lucatib/amplikt88/docs/datasheets/README.md

# Datasheets

| File | Part | Source |
|---|---|---|
| `kt88-jj.pdf` | JJ Electronic KT88: ratings, curves (ultralinear 40 % taps), pinout, glass max 52 mm, height max 125 mm | <https://www.drtube.com/datasheets/kt88-jj2003.pdf> |
| `kt88-genalex-gold-lion.pdf` | Genalex Gold Lion KT88 | <https://img.audiomania.ru/data/genalex_kt88_gold_lion_matched.pdf> |
| `ecc83-philips.pdf` | Philips ECC83, 22.2 mm max diameter | <https://frank.pocnet.net/sheets/010/e/ECC83.pdf> |
| `belton-vt8-octal-socket.pdf` | Belton VT8 octal socket (PCB mount), dimensions and PCB holes | <https://partsconnexion.com/product_images/downloads/BELTON-54795.pdf> |
