lucatib/amplikt88/3dmodels/Noval_PCB_socket.step

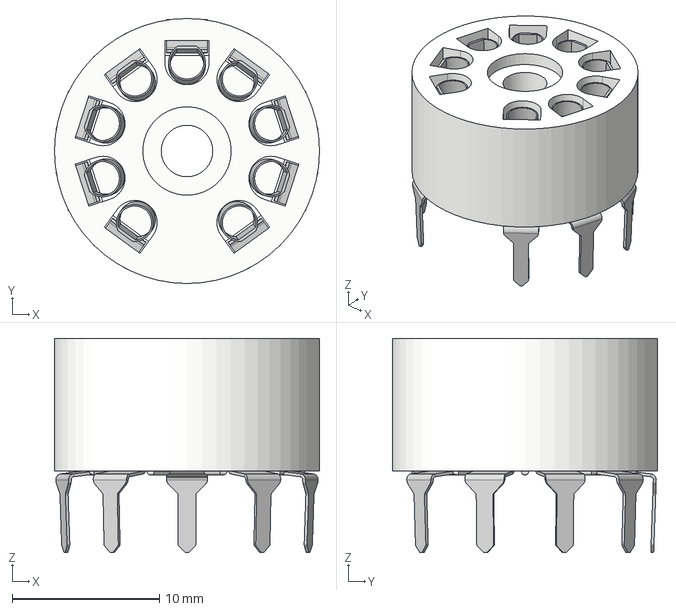
[picture p6: CAD file, 2026-11-11]
3dmodels/Noval_PCB_socket.step
18.0 x 18.0 x 14.6 mm
