lucatib/amplikt88/3dmodels/KT88.step

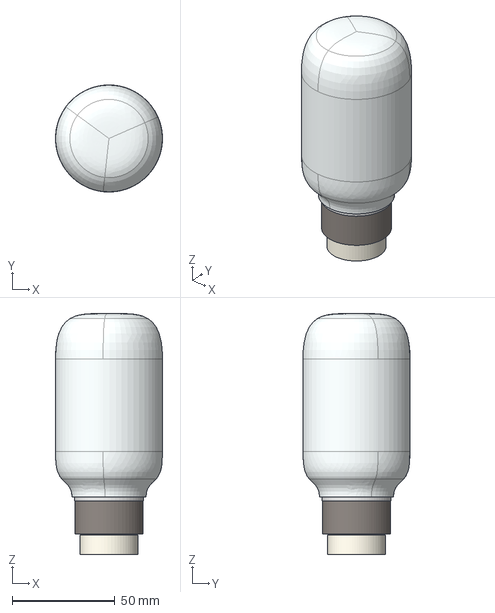
[picture p7: CAD file, 2026-11-11]
3dmodels/KT88.step
52.0 x 52.0 x 117.0 mm
