lucatib/amplikt88/3dmodels/ECC83.step

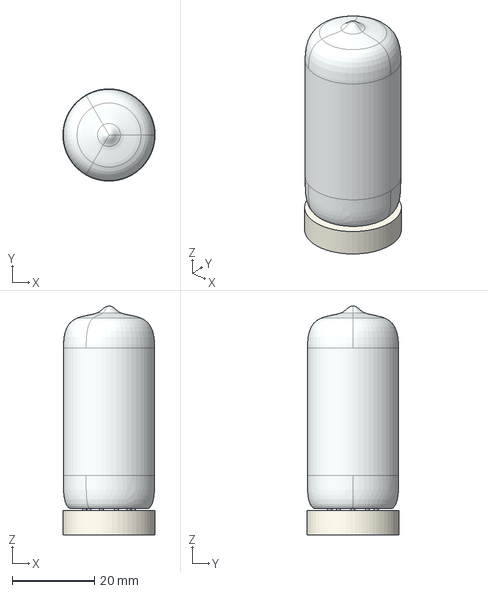
[picture p8: CAD file, 2026-11-11]
3dmodels/ECC83.step
22.4 x 22.4 x 55.6 mm
