lucatib/amplikt88/amplikt88.pdf

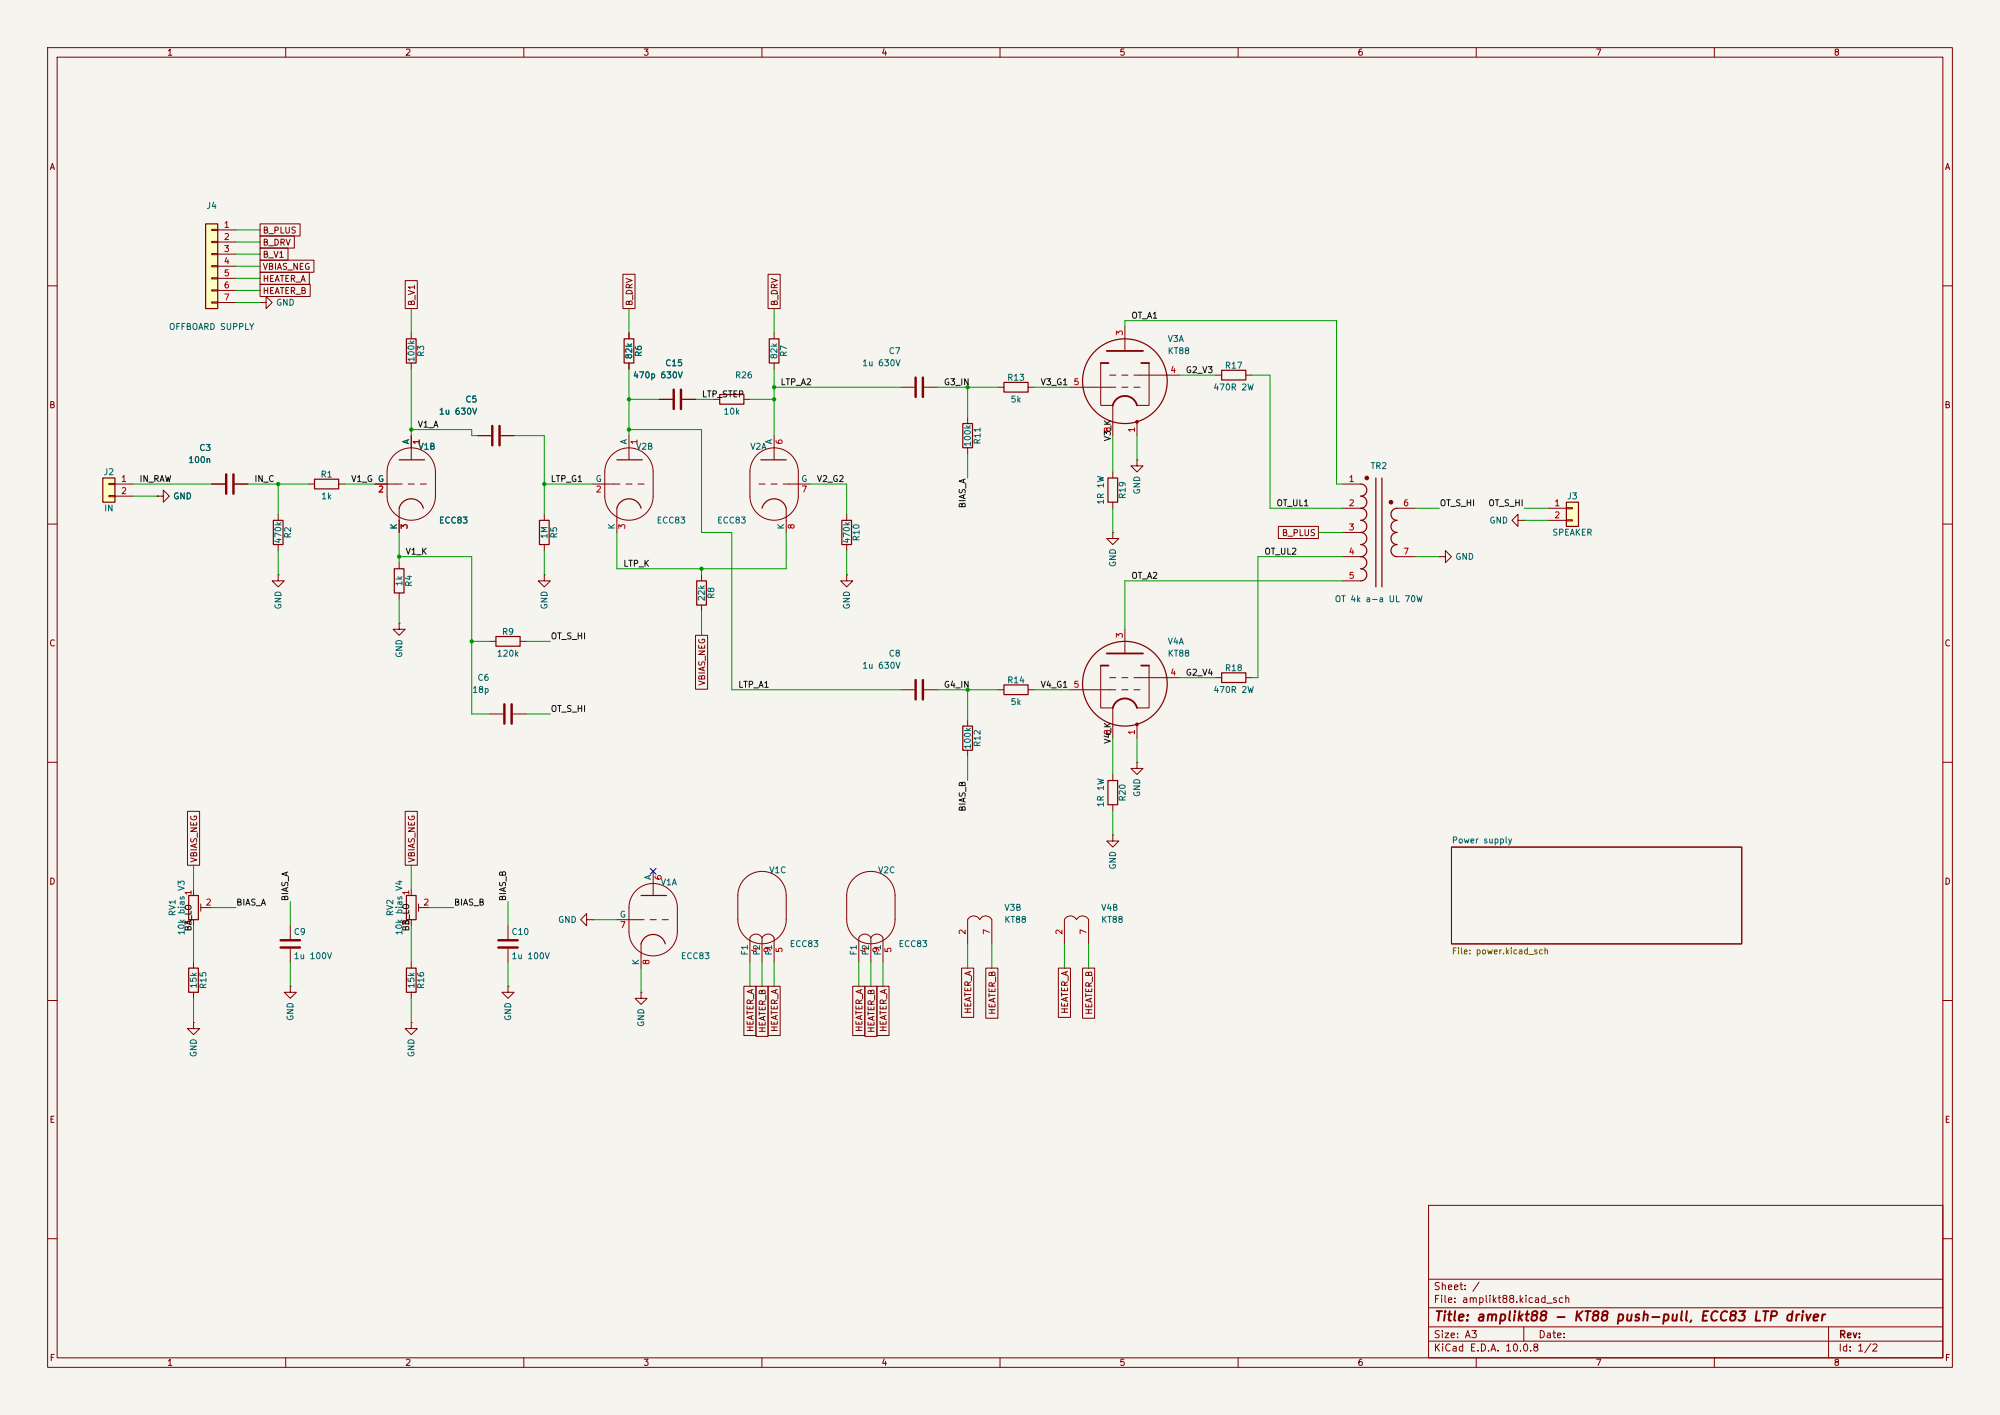
[picture p9: page 1]

Power supply File: power.kicad_sch 82k R7 GND

Sheet: /
File: amplikt88.kicad_sch
Title: amplikt88 - KT88 push-pull, ECC83 LTP driver

Size: A3 | Rev: | F Date:
KiCad E.D.A. 10.0.8 | Id: 1/2

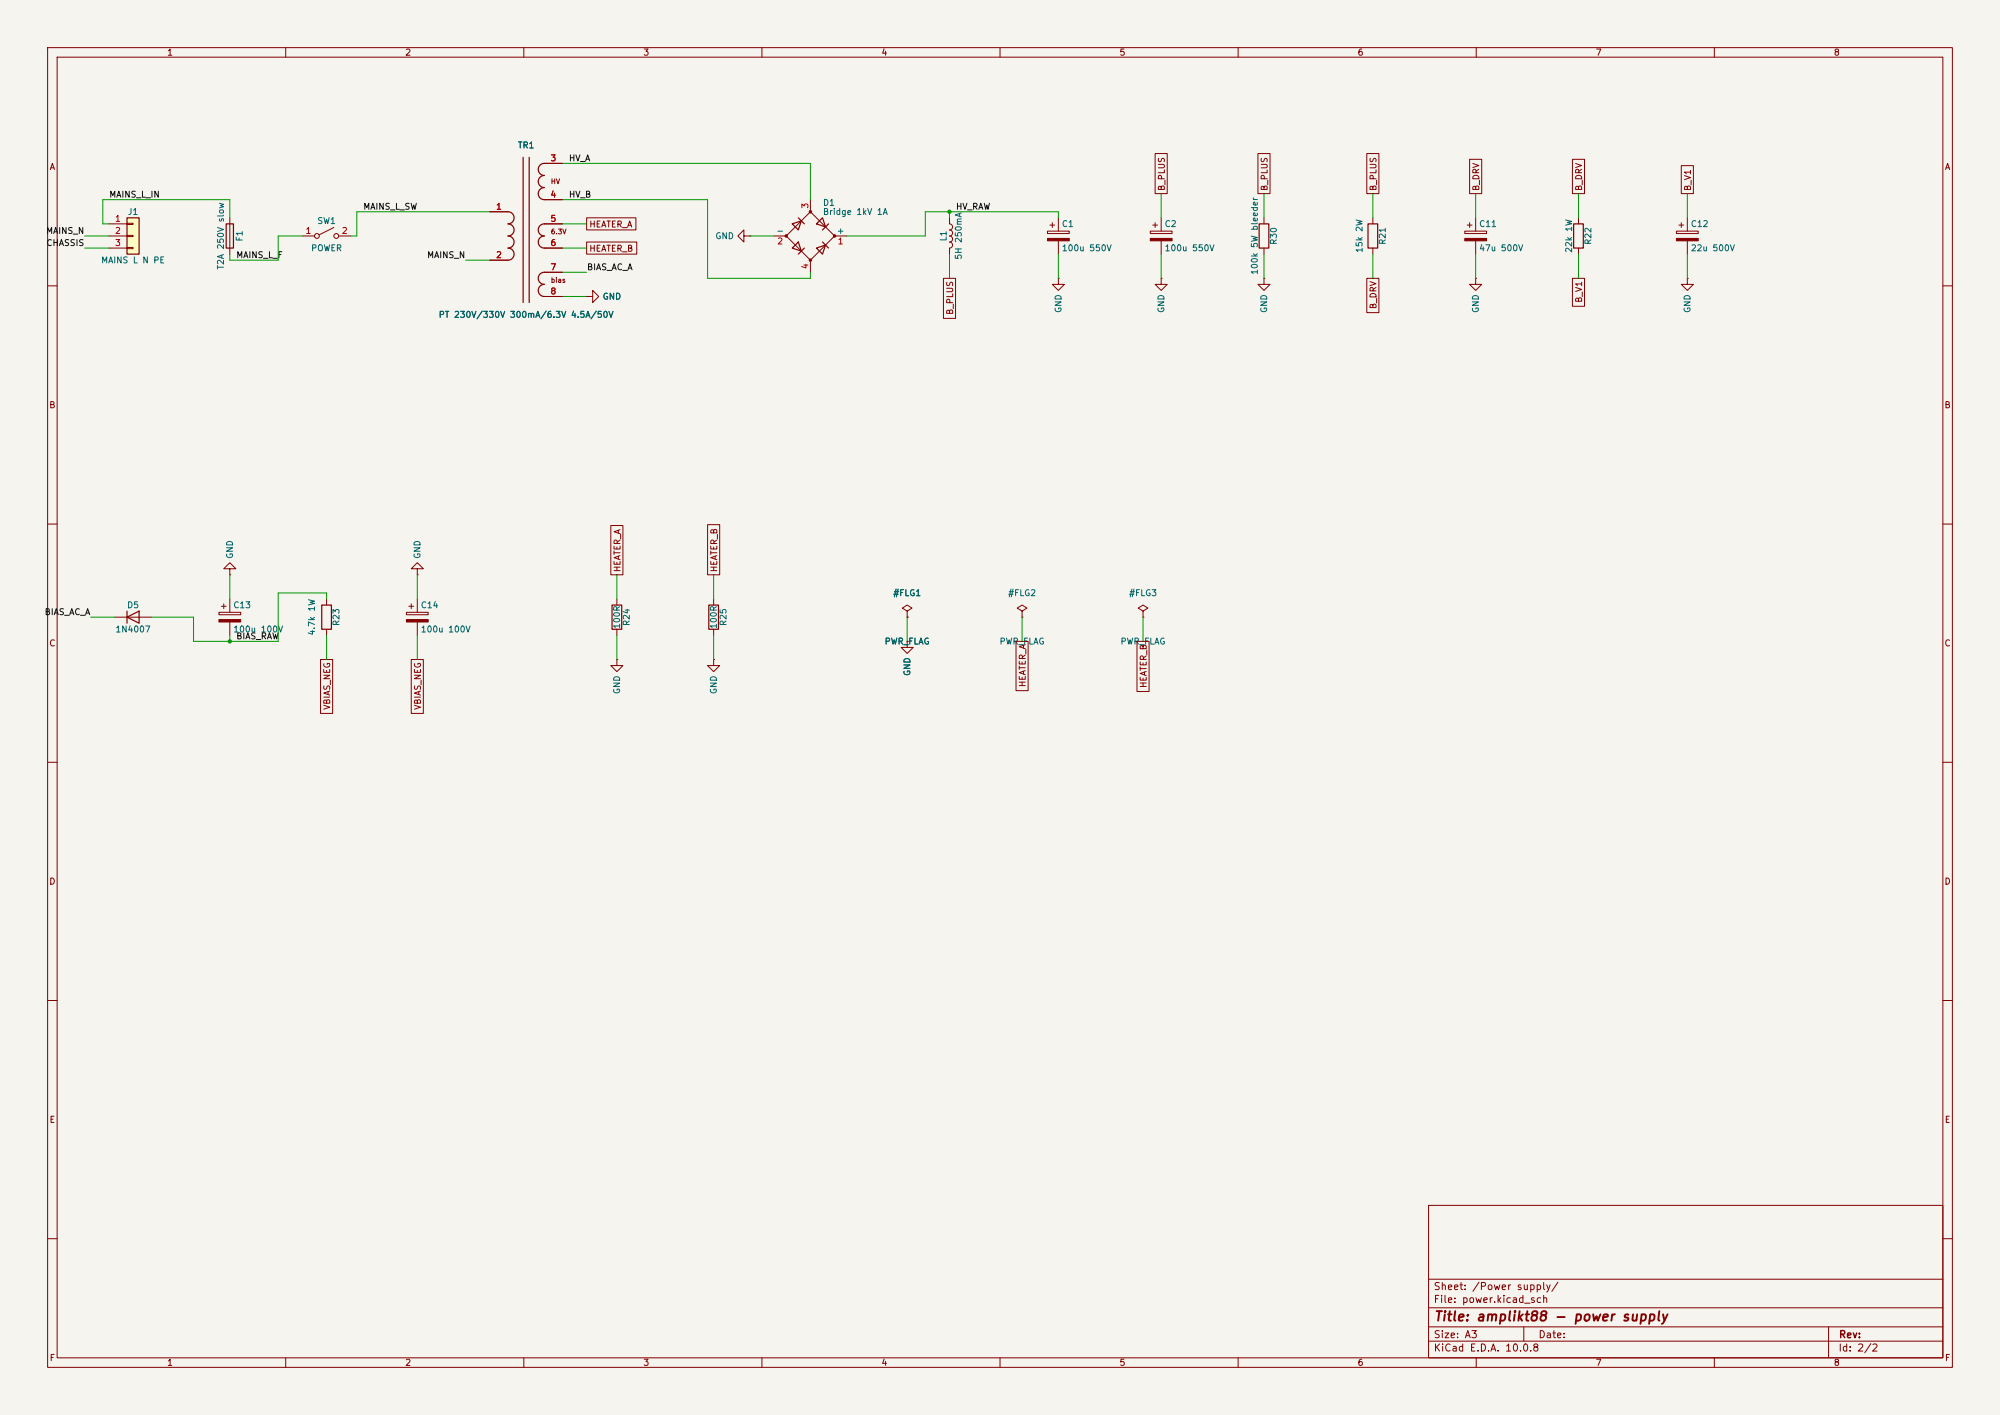
[picture p10: page 2]

Size: A3 | Rev: | F Date:
KiCad E.D.A. 10.0.8 | Id: 2/2
