lucatib/amplikt88/amplikt88.kicad_pcb

## KiCad design amplikt88.kicad_pcb (2026-11-14)

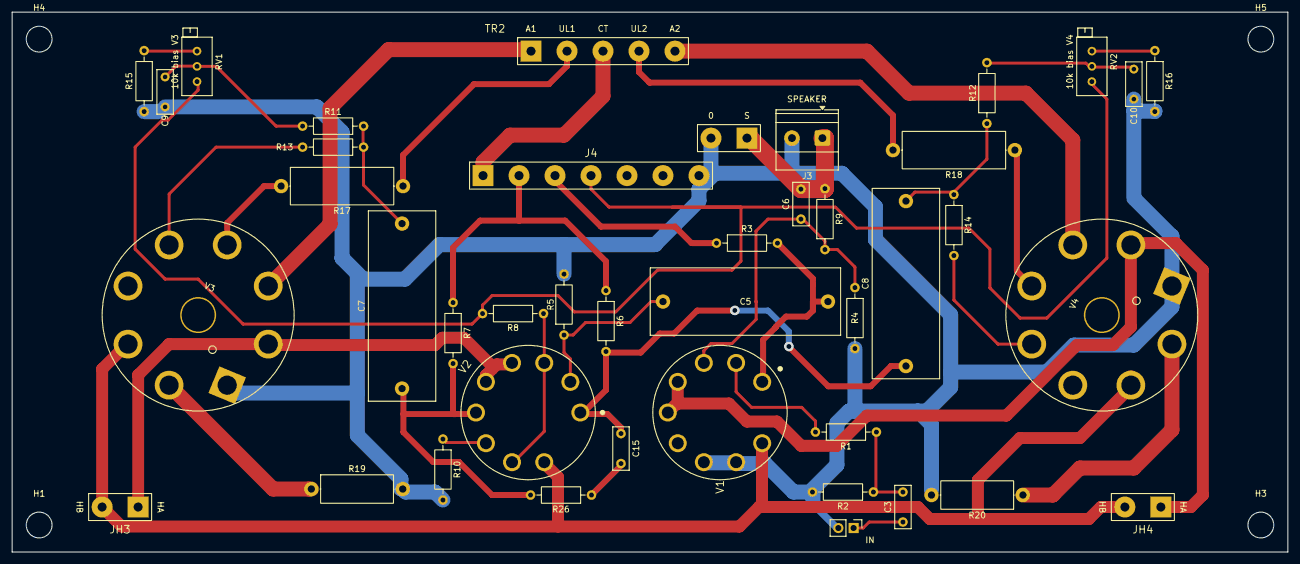
[picture p11: board amplikt88.kicad_pcb from above]

Board: 2 copper layers, 212.7 x 90.0 mm, 45 parts (0 on the bottom side), 35 nets.

Parts:
C3: 100n; C_Disc_D7.0mm_W2.5mm_P5.00mm
C5, C7, C8: 1u 630V; C_Rect_L31.5mm_W11.0mm_P27.50mm_MKS4
C6: 18p; C_Disc_D7.0mm_W2.5mm_P5.00mm
C9, C10: 1u 100V; C_Rect_L7.2mm_W2.5mm_P5.00mm
C15: 470p 630V; C_Disc_D7.0mm_W2.5mm_P5.00mm
H1, H3, H4, H5: M4; MountingHole_4.3mm_M4
J2: IN; PinHeader_1x02_P2.54mm_Vertical
J3: SPEAKER; TerminalBlock_Phoenix_MKDS-1,5-2-5.08_1x02_P5.08mm_Horizont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
J4: OFFBOARD SUPPLY; Supply_7
JH3: HEATER V3; Heater_2
JH4: HEATER V4; Heater_2
R1, R4: 1k; R_Axial_DIN0207_L6.3mm_D2.5mm_P10.16mm_Horizontal
R2, R10: 470k; R_Axial_DIN0207_L6.3mm_D2.5mm_P10.16mm_Horizontal
R3, R11, R12: 100k; R_Axial_DIN0207_L6.3mm_D2.5mm_P10.16mm_Horizontal
R5: 1M; R_Axial_DIN0207_L6.3mm_D2.5mm_P10.16mm_Horizontal
R6, R7: 82k; R_Axial_DIN0207_L6.3mm_D2.5mm_P10.16mm_Horizontal
R8: 22k; R_Axial_DIN0207_L6.3mm_D2.5mm_P10.16mm_Horizontal
R9: 120k; R_Axial_DIN0207_L6.3mm_D2.5mm_P10.16mm_Horizontal
R13, R14: 5k; R_Axial_DIN0207_L6.3mm_D2.5mm_P10.16mm_Horizontal
R15, R16: 15k; R_Axial_DIN0207_L6.3mm_D2.5mm_P10.16mm_Horizontal
R17, R18: 470R 2W; R_Axial_DIN0617_L17.0mm_D6.0mm_P20.32mm_Horizontal
R19, R20: 1R 1W; R_Axial_DIN0414_L11.9mm_D4.5mm_P15.24mm_Horizontal
R26: 10k; R_Axial_DIN0207_L6.3mm_D2.5mm_P10.16mm_Horizontal
RV1: 10k bias V3; Potentiometer_Bourns_3296X_Horizontal
RV2: 10k bias V4; Potentiometer_Bourns_3296X_Horizontal
TR2: OT 4k a-a UL 70W; OT_7
V1, V2: ECC83; Valve_Noval_ECC83
V3, V4: KT88; Valve_Octal_KT88

Connections:
/BA_LO: R15.1, RV1.3
/BB_LO: R16.1, RV2.3
/BIAS_A: C9.1, R11.2, RV1.2
/BIAS_B: C10.1, R12.2, RV2.2
/G2_V3: R17.1, V3.4
/G2_V4: R18.1, V4.4
/G3_IN: C7.2, R11.1, R13.1
/G4_IN: C8.2, R12.1, R14.1
/IN_C: C3.2, R1.1, R2.1
/IN_RAW: C3.1, J2.1
/LTP_A1: C8.1, C15.1, R6.2, V2.1
/LTP_A2: C7.1, R7.2, R26.2, V2.6
/LTP_G1: C5.2, R5.1, V2.2
/LTP_K: R8.1, V2.3, V2.8
/LTP_STEP: C15.2, R26.1
/OT_A1: TR2.1, V3.3
/OT_A2: TR2.5, V4.3
/OT_S_HI: C6.2, J3.1, R9.2, TR2.6
/OT_UL1: R17.2, TR2.2
/OT_UL2: R18.2, TR2.4
/V1_A: C5.1, R3.2, V1.1
/V1_G: R1.2, V1.2
/V1_K: C6.1, R4.1, R9.1, V1.3
/V2_G2: R10.1, V2.7
/V3_G1: R13.2, V3.5
/V3_K: R19.1, V3.8
/V4_G1: R14.2, V4.5
/V4_K: R20.1, V4.8
B_DRV: J4.2, R6.1, R7.1
B_PLUS: J4.1, TR2.3
B_V1: J4.3, R3.1
GND: C9.2, C10.2, J2.2, J3.2, J4.7, R2.2, R4.2, R5.2, R10.2, R15.2, R16.2, R19.2, R20.2, TR2.7, V1.7, V1.8, V3.1, V4.1
HEATER_A: J4.5, JH3.1, JH4.1, V1.4, V1.5, V2.4, V2.5, V3.2, V4.2
HEATER_B: J4.6, JH3.2, JH4.2, V1.9, V2.9, V3.7, V4.7
VBIAS_NEG: J4.4, R8.2, RV1.1, RV2.1
