lucatib/amplikt88/(commit log)

2026-11-10 Add KT88 push-pull amplifier schematic with ECC83 LTP driver
    Single sheet: mains, rectifier and C-L-C filter, decoupled driver rail,
    negative bias supply with per-valve trimmers, ECC83 input stage and
    long-tailed pair with global feedback on the second grid, 2x KT88 with
    ultralinear taps. ECC83, KT88 and both transformers are single-unit
    symbols in the project library with their real pin numbers.
    ERC: 0 errors, 2 warnings (a lone CHASSIS label, a 1N4007 copy that
    differs from the library).
    Claude-Session: https://claude.ai/code/session_01UGTfop4z1kKPkQUznPSMBJ
    [amplikt88.kicad_sch]
2026-11-10 Group the schematic by stage and wire the short nets
    Parts are placed in rows by function (mains and PSU, bias and heaters,
    input and driver, output) with each stage's parts next to its valve, and
    route_nets draws wires for the 21 nets that stay under 110 mm. Rails and
    other long nets stay as labels. Netlist unchanged (all 149 pins on their
    nets), ERC still 0 errors.
    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
    [amplikt88.kicad_sch]
2026-11-10 Move the power supply to its own sheet
    power.kicad_sch holds the mains input, rectifier, filter, driver rail,
    negative bias supply and heater centre tap (19 parts); the root sheet keeps
    the amplifier and a Power supply sheet symbol. B_PLUS, B_DRV, B_V1,
    VBIAS_NEG and the two heater lines cross as global labels. Netlist
    unchanged (56 parts, all 149 pins on their nets), ERC still 0 errors.
    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
    [amplikt88.kicad_sch, power.kicad_sch]
2026-11-10 Add SPICE simulation and fix the feedback loop it exposed
    KiCad exports the netlist from the schematic (Sim.* fields on the symbols,
    models in spice/amplikt88.lib); spice/simulate.py adds a bench and runs
    ngspice: idle bias, loop gain and margins, 1 kHz power and THD, square wave
    into capacitive loads.
    The simulation showed the feedback, returned to the second grid of the
    long-tailed pair, had -2 dB of loop gain. It now goes from the speaker
    terminal to the unbypassed cathode of the input stage (R9 120k, C6 18p),
    which gives 14.5 dB, 98 deg phase margin and 0.19 % THD at 38 W. The
    LTP outputs are swapped to keep the loop negative, the second pair grid is
    grounded through R10 470k, and the b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
    [amplikt88.kicad_sch, power.kicad_sch]
2026-11-10 Add simulation plots
    spice/plot.py draws closed-loop response, loop gain and phase, and the
    10 kHz square wave into 8 ohm + 1 uF for the schematic as drawn, the first
    47k/47p feedback and an ECC82 pair, with a table of the numbers beside them.
    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
2026-11-10 Round valve symbols, driver compensation and output transformer spec
    The valves are drawn as circles, one unit per section. The driver pair runs
    at 1.5 mA per triode (R8 22k, R21 15k) to reach the KT88 grid swing, and
    C15/R26 across its anodes roll the loop off before the transformer does:
    about 2 % overshoot on a 10 kHz square with 8 ohm, 0.1 uF or 1 uF.
    simulate.py reports the margins at both ends of the band, ot_study.py
    reruns the bench over transformer parameters, and
    docs/output-transformer.md is the order sheet derived from it.
    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
    [amplikt88.kicad_sch, power.kicad_sch]
2026-11-11 Add PCB layout with 2 mm KT88 current paths
    Add the amplifier PCB, offboard connector footprints, footprint assignments, project settings, and editable valve models. Preserve the restored placement and selected 2 mm current-path routing; other traces remain unrouted.
    Validation: KiCad DRC reports 22 shorts, 27 solder-mask bridges, one clearance violation, and 65 unconnected items. This is an in-progress layout.
    [ECC83.step, KT88.step, amplikt88.kicad_pcb, amplikt88.kicad_sch, power.kicad_sch]
2026-11-11 Symmetric PCB placement with HV rules and star-ground power routing
    Board stands vertically, valves horizontal. KT88s turned with heater pins
    horizontal, output transformer at the top, supply connector down the centre
    line with the star at J4 pin 7. Only the high-current paths are routed, on
    B.Cu without vias; F.Cu is a ground plane tied to the star.
    Net classes and custom rules keep nodes above 200 V 8 mm from ground, the
    mounting holes and the edge. J3 becomes a 5.08 mm screw terminal for the
    4.2 A secondary current. README gets a PCB section with the board views.
    Claude-Session: https://claude.ai/code/session_01UGTfomFoJpSxmm1Y2WvC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
    [amplikt88.kicad_pcb, amplikt88.kicad_sch]
2026-11-11 README: speaker current for the 8 ohm secondary
    Claude-Session: https://claude.ai/code/session_01UGTfomFoJpSxmm1Y2WvCrZ
2026-11-11 README: 45 degree perspective 3D view of the board with the valves
    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
2026-11-11 PCB 230 x 70 mm, noval and power resistor footprints, back view
    The board is lower and longer: bias trimmers beside the KT88s, the star
    wires along the bottom edge, A2 lifted over the speaker terminal so it keeps
    8 mm from its ground pin. The ECC83s move to Valve_ECC-83-1 (the noval pin
    circle instead of the grid layout), R17/R18 to DIN0617 for 2 W and R19/R20
    to DIN0414 for 1 W, all on the back with the other small parts.
    A rule lets pins of the same valve socket sit 1.2 mm apart, since the valve
    fixes their spacing. README gets a 3D view of the back.
    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
    [amplikt88.kicad_pcb, amplikt88.kicad_sch]
2026-11-11 PCB 230 x 60 mm with every part on the valve side
    All footprints move to the top, next to the valves; the tracks stay on
    B.Cu and the ground plane on F.Cu. To fit 60 mm the valves move up, A2
    rises to 12 mm over the right KT88 once it is past the speaker terminal,
    and the supply wire pads J4 go from 7.5 to 6 mm pitch (2.5 mm between the
    HV pads still holds). Corner holes move to 4 mm from the edges to keep
    8 mm from the coupling capacitors.
    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
    [amplikt88.kicad_pcb]
2026-11-11 Keep 4 mm free around the KT88 sockets
    New DRC rule: courtyard clearance of 4 mm between each KT88 and any other
    part. R11-R14 move above or beside the keep-out, R19/R20 below it, C5 into
    the gap between V3 and V1 with its HV end away from V1's grounded pins.
    V1/V2 shift 1 mm out, the star wires enter J4.7 at 45 degrees around R1
    and the centre hole, the right bias trimmer sits between R20 and R16.
    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
    [amplikt88.kicad_pcb]
2026-11-11 Keep 4 mm free around the KT88 glass
    The KT88 footprint becomes Valve_Octal_KT88 in the project library: the
    KiCad octal socket with the courtyard set to the glass envelope, 52 mm
    across. The 4 mm courtyard rule now measures from the glass, so each KT88
    keeps a 60 mm circle to itself and the board grows to 259 x 60 mm.
    The KT88s move to the ends with C7/C8, the grid stoppers and the bias
    trimmers outside them; the cathode resistors sit in the corners left by the
    glass. KT88 pin 1 (shell) goes to the plane, so the star carries only the
    two cathode wires. J3 moves closer to TR2 so A2 can climb over the right
    KT88 earlier.
    Claude-Session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
    [amplikt88.kicad_pcb, amplikt88.kicad_sch]
2026-11-11 Add KT88, ECC83 and octal socket datasheets
    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
2026-11-11 Use a JJ KT88 3D model on the board
    KT88_JJ.wrl and KT88_JJ.stpz come from a SketchUp model of the JJ KT88:
    scaled from 0.1 mm to mm, base at Z=0, 52.6 mm across, the base opaque and
    the glass transparent amber in the VRML. The STEP is the mesh reduced to
    25 102 triangles and gzipped (7.6 MB) so it stays under GitHub's limits.
    V3/V4 and Valve_Octal_KT88 point at it with the old seat offset.
    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
    [amplikt88.kicad_pcb]
2026-11-11 Seat the JJ KT88 model on the PCB
    The model has no socket of its own, so its base now starts at the board
    surface (Z offset 0 instead of 10 mm).
    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
    [amplikt88.kicad_pcb]
2026-11-11 Match the KT88 footprint to the JJ model's socket
    The JJ model is the valve in its socket: eight contacts with 2.3 mm bores
    on a 16 mm circle, the key between two of them. Valve_Octal_KT88 now has
    its pads there (2.5 mm holes, 4 mm pads, origin at the socket centre)
    instead of KiCad's octal layout on a ~21.6 mm square, and the model is
    turned -112.5 deg so the key falls between pads 1 and 8. A second model
    adds the socket's solder tails through the board. The KT88 power tracks
    are re-hooked to the new pad positions; DRC is clean apart from silk.
    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
    [KT88_JJ_socket_tails.step, amplikt88.kicad_pcb]
2026-11-11 Put the KT88 holes on the socket's solder tabs
    The JJ model is the valve in its socket: the valve pins go into the socket
    contacts, and the socket's own tabs go to the PCB. Valve_Octal_KT88 now has
    its pads on those tabs (25.3 mm circle, 3.2 mm holes for the 2.9 x 0.5 mm
    blades, 4.8 mm pads) and the model sits 4.6 mm lower, so the straight part
    of the tabs crosses the board; the extra tail model is gone. The KT88s
    move down 1.5 mm to fit A2 and G2 over the right valve with the larger
    pads, the cathode resistors and bias parts move with the glass keep-out.
    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
    [KT88_JJ_socket_tails.step, amplikt88.kicad_pcb]
2026-11-11 ECC83 in a noval PCB socket, with real 3D models
    Valve_Noval_ECC83 puts the pads on the tabs of a noval PCB socket (17.4 mm
    circle, 2 mm holes, origin at the socket centre, courtyard the 21.5 mm
    glass). Its models are that socket's STEP, seated so the tabs cross the
    board, and an ECC83 RFT tube in it, converted from a STEP render scene with
    the table and backdrop removed. Pad 1 sits next to the gap as in both
    models, so neither is rotated.
    The ECC83s move 3 mm down and 0.5 mm out and are placed by the socket
    centre, UL2 runs at 25.6 mm, the input parts under V1 go in one row and the
    driver resistors shift 0.6 mm, to keep the 8 mm and 2.5 mm HV rules with
    the wider pin ring.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
    [Noval_PCB_socket.step, amplikt88.kicad_pcb, amplikt88.kicad_sch]
2026-11-12 PCB 259 x 70 mm: ECC83s on the centre line, connectors on the top edge
    - LTP ECC83 on the centre line near the bottom, input ECC83 32 mm above it.
    - Supply, output transformer and speaker on the top edge; OT footprint with
    CT on the centre line and A1/UL1, A2/UL2 mirrored about it.
    - Bias trimmers changed to side-adjust 3296X, side by side at the bottom edge.
    - M4 mounting holes in the four corners and between the ECC83s.
    - Power tracks rerouted; star ground up the left edge to J4 pin 7.
    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
    [amplikt88.kicad_pcb, amplikt88.kicad_sch]
2026-11-12 PCB 240 x 70 mm: KT88s point mirrored, power routed
    V4 is V3 turned 180 degrees about the board centre, so anode, screen and
    cathode tracks are equal and short on both valves. Film capacitors stand
    vertical. CT moves under the B+ pad and V1 turns so the driver rails and
    one LTP anode can cross the centre column. B_DRV, B_V1, VBIAS_NEG and the
    heaters are routed; signals are not yet.
    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
    [amplikt88.kicad_pcb]
2026-11-14 Golden sample: base route on 212.67 x 88 mm board, schematic in README
    [amplikt88.kicad_pcb, amplikt88.kicad_sch, power.kicad_sch]
2026-11-14 KT88s up 4 mm, symmetric holes, TR2 secondary below UL2, route finished
    - M4 holes 4.5 mm from every edge; V3/V4 4 mm higher, tracks dragged along
    - Missing connections routed without touching the golden route (5 heater
    links left: not possible on one face without crossings)
    - UL2 runs beside A2; TR2 pins 6/7 and J3 moved down to y 11.5, clear of
    the 8 mm anode and 6.3 mm UL rules; secondary at 3 mm
    - Board edge clearance rules dropped: no edge touches bracket or chassis
    [amplikt88.kicad_pcb]
2026-11-14 DRC clean: 90 mm board, 3 mm track edge rule, V3 cathode and G2 on top, LTP_A2 under R10
    - Outline fixed (stray Edge.Cuts segments removed), board 90 mm tall,
    top holes 4.5 mm from the edge, TR2 labels inside
    - Tracks at least 3 mm from the edge; bottom GND run rerouted
    - R17 straddles the A1 track; V3 heater A through the socket so the
    cathode reaches R19 on F.Cu
    - LTP_A1: two vias and a B.Cu jump kept as a named exception
    - R10 0.25 mm down, LTP_A2 centred under it; all tracks 0/45/90
    - KT88 glass rule stays 4 mm; parts checked in 3D excluded by name
    [amplikt88.kicad_pcb]
2026-11-14 Schematic heaters restored, README brought up to date, JH and TR2 footprints fixed
    - Schematic back to HEATER_A / HEATER_B only: the per-valve heater labels and
    J5-J8 were an unwanted change committed by mistake in 3855c3e; restored
    from the KiCad backup, ERC clean, SVGs and PDF re-exported
    - README PCB section rewritten for the current 212.67 x 90 mm board; 3D
    renders and routing plot regenerated, ground plane image removed
    - JH1-JH4 now on amplikt88_board:Heater_2 (were stripped OT_7 copies),
    courtyard exception against the valves after a 3D check
    - OT_7 library footprint updated to the board's secondary pad position
    - DRC: no errors, 5 intended heater links, 8 silkscreen warnings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
    [amplikt88.kicad_pcb, amplikt88.kicad_sch]
2026-11-14 PCB cleanup: HV clearances around R5 and C8, stray stubs removed, README updated
    GND star kept clear of C8, the LTP_A1 jumper stub removed, R4 and R5
    references moved off neighbouring outlines. README: J4 position,
    LTP_A1 jump length, DRC and schematic parity summary.
    [amplikt88.kicad_pcb]
2026-11-14 README images re-rendered from the current board
    3D views (top, bottom, perspective) and the F.Cu/B.Cu routing plot.
